adafruit/Adafruit-1.3-inch-240x240-TFT-PCB/Adafruit 1.3in 240x240 IPS TFT EYESPI.brd

## EAGLE design Adafruit 1.3in 240x240 IPS TFT EYESPI.brd (2023-07-24)

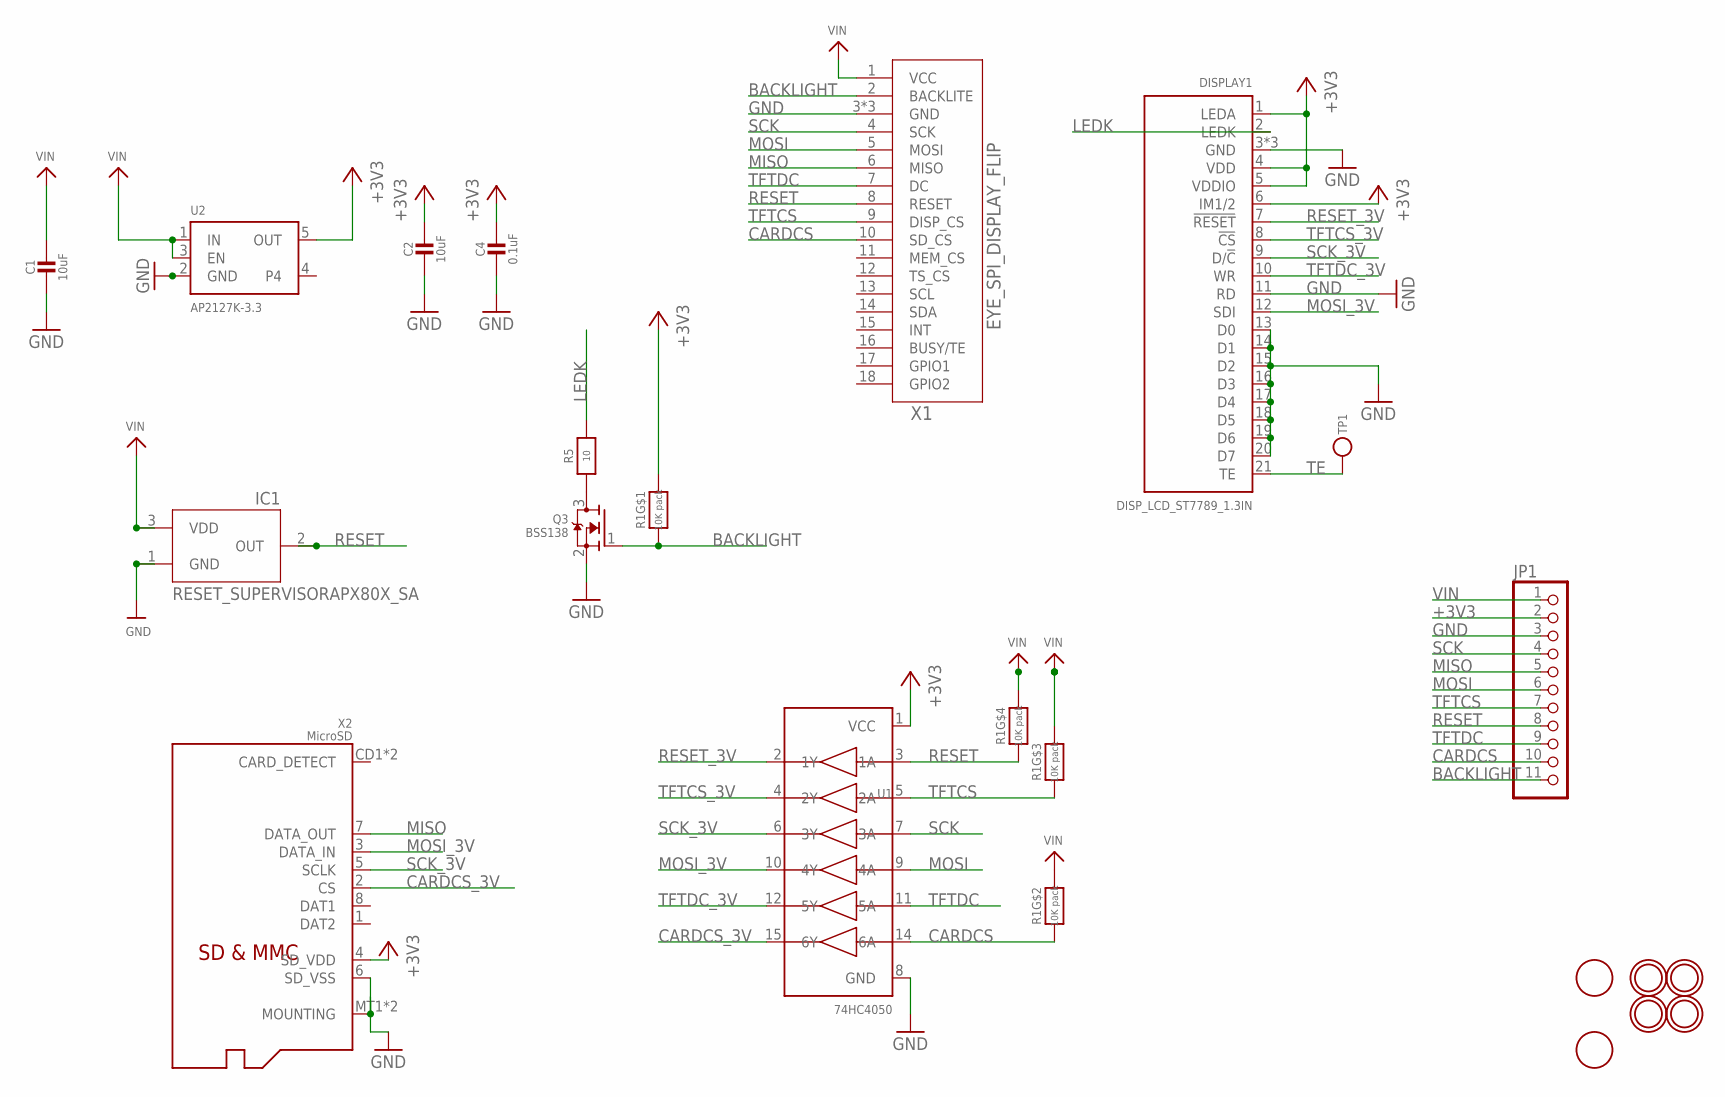
[picture p2: schematic Adafruit 1.3in 240x240 IPS TFT EYESPI.sch]

Parts:
C1, C2: 10uF; 0805-NO
C4: 0.1uF; 0603-NO
DISPLAY1: DISP_LCD_ST7789_1.3IN; TFT_1.3IN_240X240_24P
IC1: RESET_SUPERVISORAPX80X_SA; SOT23-WIDE
JP1: HEADER-1X1176MIL; 1X11_ROUND_76
Q3: BSS138; SOT23-WIDE
R1: 10K pack; RESPACK_4X0603
R5: 10; 0603-NO
TP1: TESTPOINTROUND1.5MM; TESTPOINT_ROUND_1.5MM
U1: 74HC4050; TSSOP16
U2: AP2127K-3.3; SOT23-5
U$4, U$5: FIDUCIAL; FIDUCIAL_1MM
U$7, U$8, U$9, U$10: MOUNTINGHOLE2.5; MOUNTINGHOLE_2.5_PLATED
X1: EYE_SPI_DISPLAY_FLIP; EYE_SPI_DISPLAY_BOTCONTACT
X2: MicroSD; MICROSD

Connections:
+3V3: C2.1, C4.1, DISPLAY1.1 (LEDA), DISPLAY1.4 (VDD), DISPLAY1.5 (VDDIO), DISPLAY1.6 (IM1/2), JP1.2, R1.8 (2), U1.1 (VCC), U2.5 (OUT), X2.4 (SD_VDD)
BACKLIGHT: JP1.11, Q3.1 (G), R1.1, X1.2 (BACKLITE)
CARDCS: JP1.10, R1.2 (1), U1.14 (6A), X1.10 (SD_CS)
CARDCS_3V: U1.15 (6Y), X2.2 (CS)
GND: C1.2, C2.2, C4.2, DISPLAY1.3 (GND), DISPLAY1.11 (RD), DISPLAY1.13 (D0), DISPLAY1.14 (D1), DISPLAY1.15 (D2), DISPLAY1.16 (D3), DISPLAY1.17 (D4), DISPLAY1.18 (D5), DISPLAY1.19 (D6), DISPLAY1.20 (D7), DISPLAY1.23 (GND), DISPLAY1.24 (GND), IC1.1 (GND), JP1.3, Q3.2 (S), U1.8 (GND), U2.2 (GND), X1.3 (GND), X1.SUPPORT1 (GND), X1.SUPPORT2 (GND), X2.6 (SD_VSS), X2.MT1 (MOUNTING), X2.MT2 (MOUNTING)
LEDK: DISPLAY1.2 (LEDK), R5.2
MISO: JP1.5, X1.6 (MISO), X2.7 (DATA_OUT)
MOSI: JP1.6, U1.9 (4A), X1.5 (MOSI)
MOSI_3V: DISPLAY1.12 (SDI), U1.10 (4Y), X2.3 (DATA_IN)
unnamed: Q3.3 (D), R5.1
RESET: IC1.2 (OUT), JP1.8, R1.4 (1), U1.3 (1A), X1.8 (RESET)
RESET_3V: DISPLAY1.7 (!RESET), U1.2 (1Y)
SCK: JP1.4, U1.7 (3A), X1.4 (SCK)
SCK_3V: DISPLAY1.9 (D/!C), U1.6 (3Y), X2.5 (SCLK)
TE: DISPLAY1.21 (TE), TP1.P$1
TFTCS: JP1.7, R1.3 (1), U1.5 (2A), X1.9 (DISP_CS)
TFTCS_3V: DISPLAY1.8 (!CS), U1.4 (2Y)
TFTDC: JP1.9, U1.11 (5A), X1.7 (DC)
TFTDC_3V: DISPLAY1.10 (WR), U1.12 (5Y)
VIN: C1.1, IC1.3 (VDD), JP1.1, R1.5 (2), R1.6 (2), R1.7 (2), U2.1 (IN), U2.3 (EN), X1.1 (VCC)

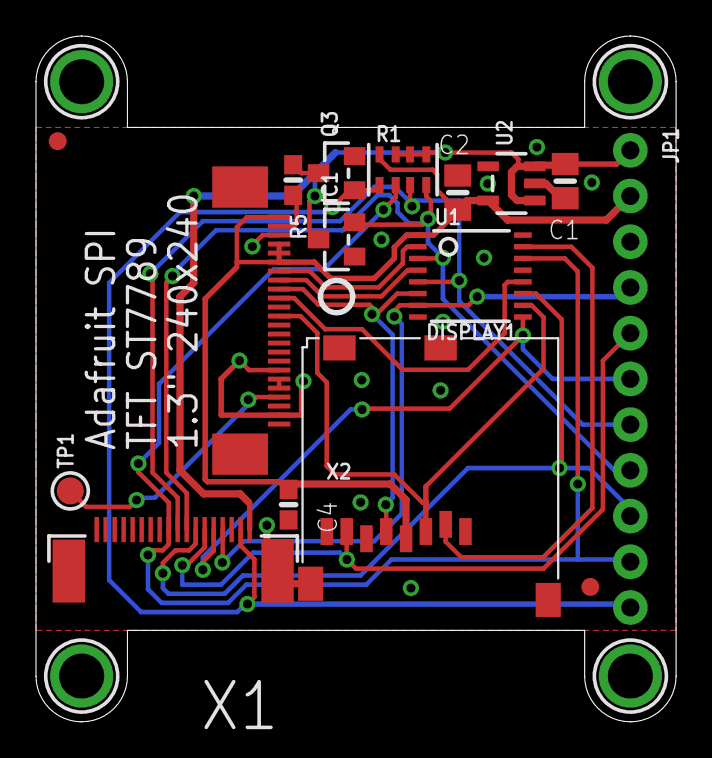
[picture p3: board Adafruit 1.3in 240x240 IPS TFT EYESPI.brd from above]

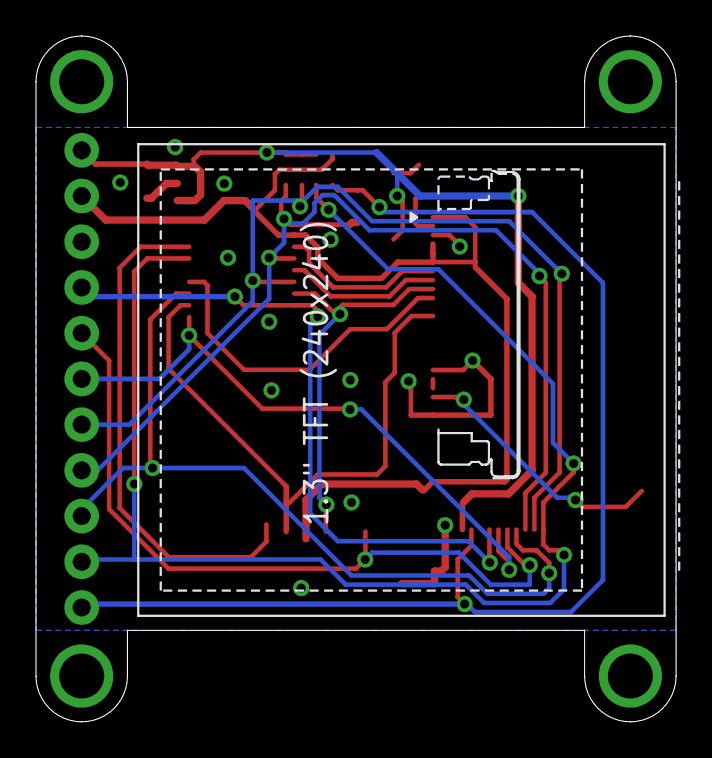
[picture p4: board Adafruit 1.3in 240x240 IPS TFT EYESPI.brd from below]

Board: 2 copper layers, 35.6 x 38.1 mm, 45 parts (11 on the bottom side), 20 nets.

Other parts of the board:
PLABEL0: PLABEL0
PLABEL1: PLABEL1
PLABEL2: PLABEL2
PLABEL3: PLABEL3
PLABEL4: PLABEL4
PLABEL5: PLABEL5
PLABEL6: PLABEL6
PLABEL7: PLABEL7
PLABEL8: PLABEL8
PLABEL9: PLABEL9
PLABEL10: PLABEL10
PLABEL11: PLABEL11
PLABEL13: PLABEL13
PLABEL14: PLABEL14
PLABEL15: PLABEL15
PLABEL16: PLABEL16
PLABEL17: PLABEL17
PLABEL18: PLABEL18
PLABEL19: PLABEL19
PLABEL20: PLABEL20
PLABEL21: PLABEL21
PLABEL22: PLABEL22
PLABEL23: PLABEL23
PLABEL24: PLABEL24
U$2: PCBFEAT-REV-040
