adafruit/Adafruit-1.3-inch-240x240-TFT-PCB/Adafruit 1.3in 240x240 IPS TFT.brd

## EAGLE design Adafruit 1.3in 240x240 IPS TFT.brd (2019-08-07)

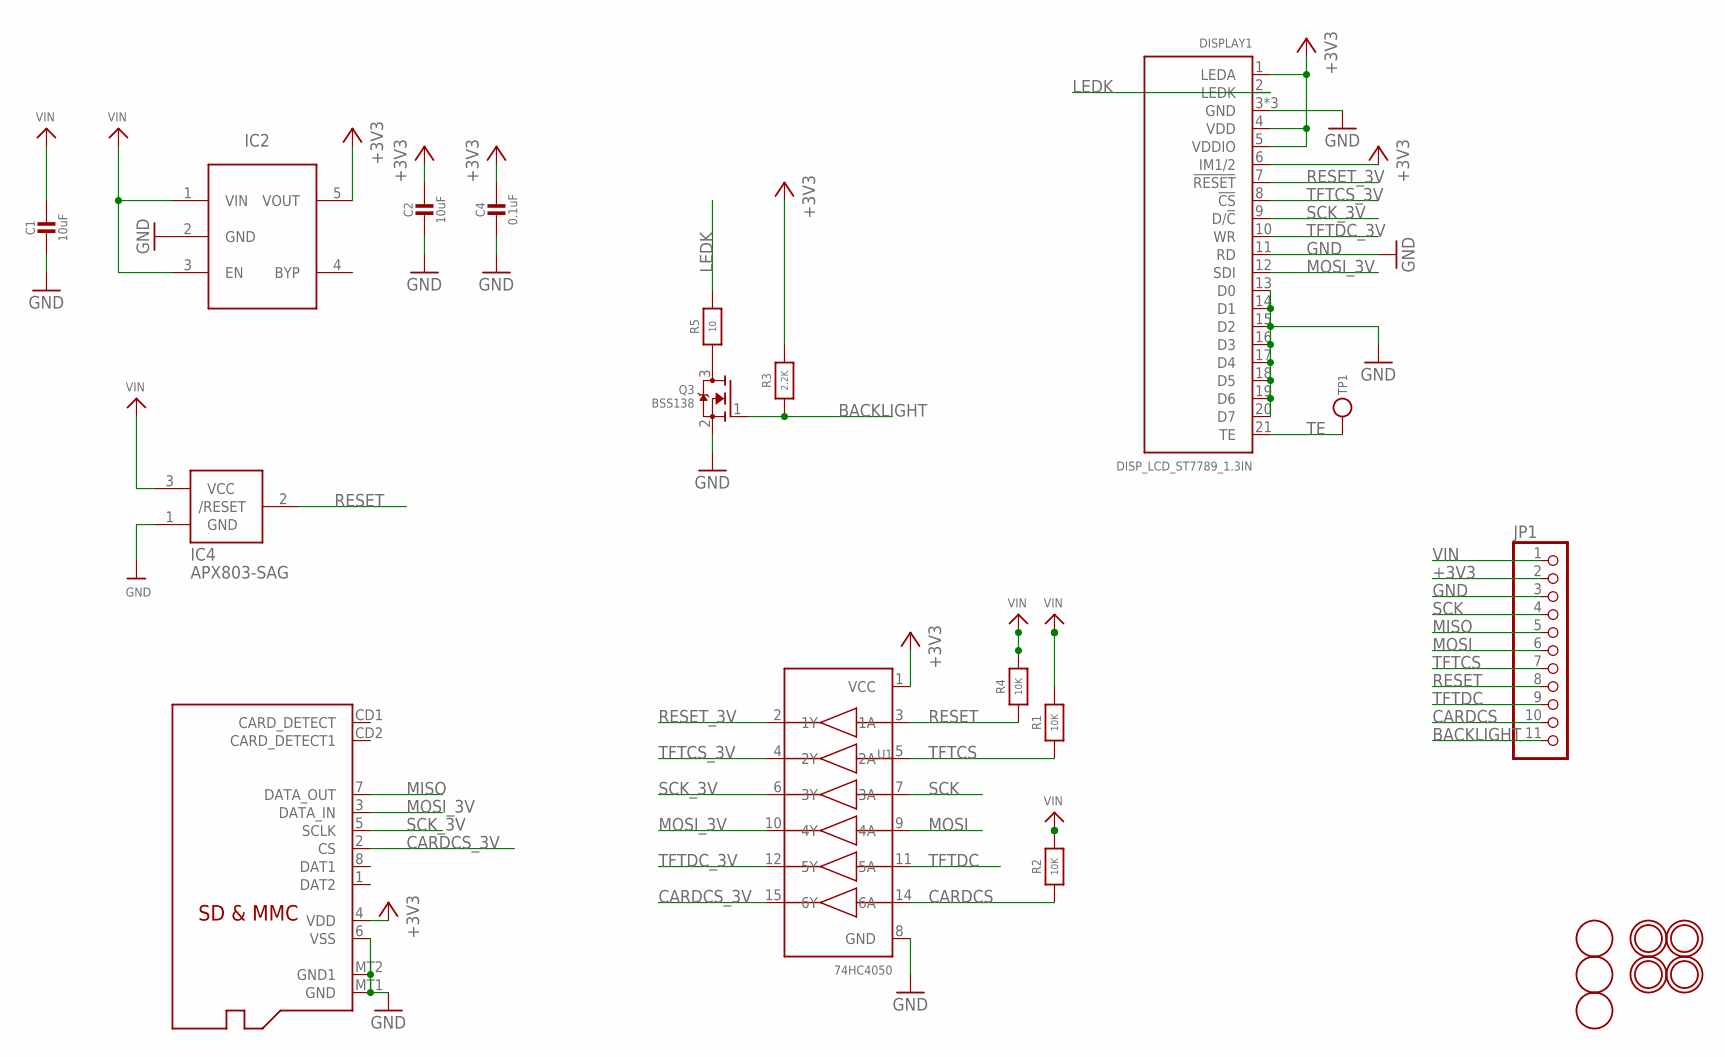
[picture p5: schematic Adafruit 1.3in 240x240 IPS TFT.sch]

Parts:
C1, C2: 10uF; 0805-NO
C4: 0.1uF; 0603-NO
DISPLAY1: DISP_LCD_ST7789_1.3IN; TFT_1.3IN_240X240_24P
IC2: AP2112K-3.3; SOT23-5L
IC4: APX803-SAG; SOT23
JP1: HEADER-1X1176MIL; 1X11_ROUND_76
Q2: MICROSD
Q3: BSS138; SOT23-WIDE
R1, R2, R4: 10K; 0603-NO
R3: 2.2K; 0603-NO
R5: 10; 0603-NO
TP1: TESTPOINTROUND1.5MM; TESTPOINT_ROUND_1.5MM
U1: 74HC4050; TSSOP16
U$3, U$4, U$5: FIDUCIAL; FIDUCIAL_1MM
U$7, U$8, U$9, U$10: MOUNTINGHOLE2.5; MOUNTINGHOLE_2.5_PLATED

Connections:
+3V3: C2.1, C4.1, DISPLAY1.1 (LEDA), DISPLAY1.4 (VDD), DISPLAY1.5 (VDDIO), DISPLAY1.6 (IM1/2), IC2.5 (VOUT), JP1.2, Q2.4 (VDD), R3.2, U1.1 (VCC)
BACKLIGHT: JP1.11, Q3.1 (G), R3.1
CARDCS: JP1.10, R2.1, U1.14 (6A)
CARDCS_3V: Q2.2 (CS), U1.15 (6Y)
GND: C1.2, C2.2, C4.2, DISPLAY1.3 (GND), DISPLAY1.11 (RD), DISPLAY1.13 (D0), DISPLAY1.14 (D1), DISPLAY1.15 (D2), DISPLAY1.16 (D3), DISPLAY1.17 (D4), DISPLAY1.18 (D5), DISPLAY1.19 (D6), DISPLAY1.20 (D7), DISPLAY1.23 (GND), DISPLAY1.24 (GND), IC2.2 (GND), IC4.1 (GND), JP1.3, Q2.6 (VSS), Q2.MT1 (GND), Q2.MT2 (GND1), Q3.2 (S), U1.8 (GND)
LEDK: DISPLAY1.2 (LEDK), R5.2
MISO: JP1.5, Q2.7 (DATA_OUT)
MOSI: JP1.6, U1.9 (4A)
MOSI_3V: DISPLAY1.12 (SDI), Q2.3 (DATA_IN), U1.10 (4Y)
unnamed: Q3.3 (D), R5.1
RESET: IC4.2 (/RESET), JP1.8, R4.1, U1.3 (1A)
RESET_3V: DISPLAY1.7 (!RESET), U1.2 (1Y)
SCK: JP1.4, U1.7 (3A)
SCK_3V: DISPLAY1.9 (D/!C), Q2.5 (SCLK), U1.6 (3Y)
TE: DISPLAY1.21 (TE), TP1.P$1
TFTCS: JP1.7, R1.1, U1.5 (2A)
TFTCS_3V: DISPLAY1.8 (!CS), U1.4 (2Y)
TFTDC: JP1.9, U1.11 (5A)
TFTDC_3V: DISPLAY1.10 (WR), U1.12 (5Y)
VIN: C1.1, IC2.1 (VIN), IC2.3 (EN), IC4.3 (VCC), JP1.1, R1.2, R2.2, R4.2

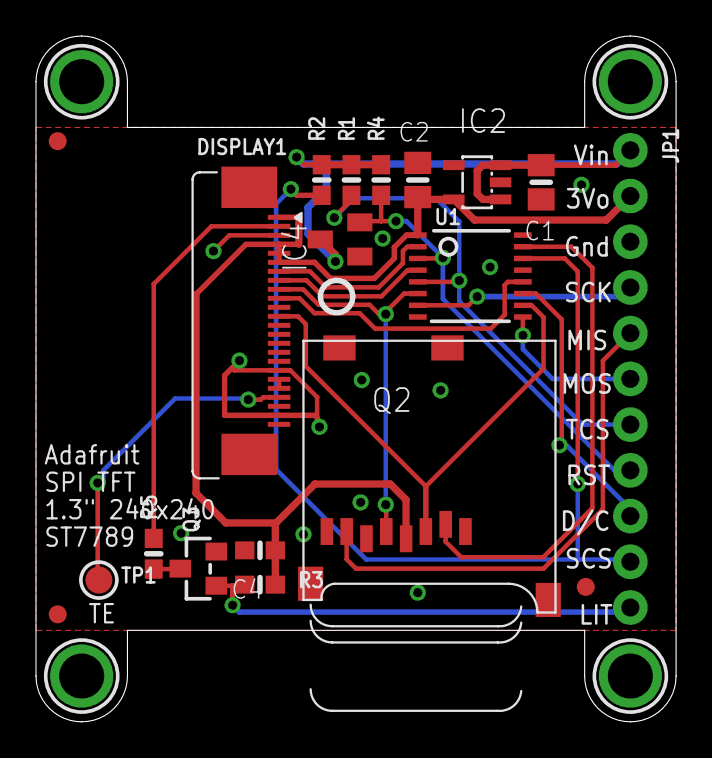
[picture p6: board Adafruit 1.3in 240x240 IPS TFT.brd from above]

Board: 2 copper layers, 35.6 x 38.1 mm, 24 parts (0 on the bottom side), 20 nets.

Other parts of the board:
U$2: PCBFEAT-REV-040
