adafruit/Adafruit-1.3-inch-240x240-TFT-PCB/(commit log)

2019-08-07 Adding board/repo files.
    [1.3in 240x240 IPS TFT.brd, 1.3in 240x240 IPS TFT.sch]
2019-08-07 Updated board file names.
    [Adafruit 1.3in 240x240 IPS TFT.brd, Adafruit 1.3in 240x240 IPS TFT.sch]
2023-07-24 Add updated board files.
    [Adafruit 1.3in 240x240 IPS TFT EYESPI.brd, Adafruit 1.3in 240x240 IPS TFT EYESPI.sch]
